Daisy000888/esp32-uart-4g-gateway/doc/preview-3d.png

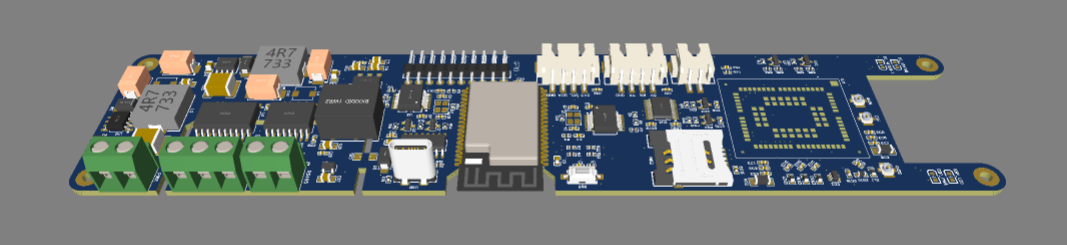
doc/preview-3d.png
