Daisy000888/esp32-uart-4g-gateway/hardware/fabrication/BOM_PCB_ESP32 Quad UARTs with 4G and Display_2022-10-01.csv

ID | Name | Designator | Footprint | Quantity | Manufacturer Part | Manufacturer | Supplier | Supplier Part | Price
1 | PZ254V-12-6P | UART0SEL | HDR-TH_6P-P2.54-V-M-R2-C3-S2.54 | 1 | PZ254V-12-6P | XFCN | LCSC | C492420 | 0.034
2 | 1nF | C35 | C1206 | 1 | 1206B102K202NT | FH | LCSC | C9196 | 0.011
3 | 1.2MΩ | R26 | R1206 | 1 | 1206W4F1204T5E | UniOhm | LCSC | C22107 | 0.004
4 | 1MΩ | R21 | R0402 | 1 | 0402WGF1004TCE | UniOhm | LCSC | C26083
5 | 19-217/GHC-YR1S2/3T | EG_NETLIGHT,EG_STATUS,ESP_LED,ESP_PWR | LED0603-R-RD | 4 | 19-217/GHC-YR1S2/3T | EVERLIGHT | LCSC | C72043 | 0.028
6 | 100nF | C34,C31,C32,C30,EC14,C20,C21,C22,C23,C26,C28,C3,C6,C11,C12,EC3,EC7,EC13,C1 | C0402 | 19 | CL05B104KB54PNC | Samsung Electro-Mechanics | LCSC | C307331 | 0.007
7 | 10kΩ | R20,R4,R5,R6,R14,R1 | R0402 | 6 | 0402WGF1002TCE | UniOhm | LCSC | C25744 | 0.001
8 | 1kΩ | R22,R23 | R0402 | 2 | 0402WGF1001TCE | UniOhm | LCSC | C11702
9 | A2501WR-S-2P | ESP_BTN | CONN-SMD_A2501WR-S-2P | 1 | A2501WR-S-2P | Changjiang Connectors | LCSC | C273220 | 0.173
10 | KH-IPEX-K501-29 | DIV,GNSS,MAIN | ANT-SMD_KH-IPEX-K501-29 | 3 | KH-IPEX-K501-29 | Shenzhen Kinghelm Elec | LCSC | C411563 | 0.071
11 | XC6206P332MR | U9 | SOT-23-3_L2.9-W1.6-P1.90-LS2.8-BR | 1 | XC6206P332MR | TOREX | LCSC | C5446 | 0.103
12 | B0505D-1WR2 | U8 | PWRM-TH_BXXXXD-1WR2 | 1 | B0505D-1WR2 | MORNSUN | LCSC | C40604 | 2.595
13 | 22uF | C14,C15,C29,C24,C25,C27 | C0805 | 6 | CL21A226MPQNNNE | SAMSUNG | LCSC | C29277 | 0.009
14 | 22uF/50V | C37,C43 | C2220 | 2 | FS55X226K500EHG | PSA(Prosperity Dielectrics) | LCSC | C784103 | 0.651
15 | 1uF/50V | C39,C44 | C0805 | 2 | CL21B105KBFNNNE | SAMSUNG | LCSC | C28323 | 0.004
16 | 220uF | C40,C41,C45,C46 | CAP-SMD_L7.3-W4.3-R-RD | 4 | TAJD227K010RNJ | AVX | LCSC | C8024 | 0.492
17 | 1uF | C42,C47 | C0805 | 2 | CL21B105KBFNNNE | SAMSUNG | LCSC | C28323 | 0.004
18 | TPD1E1B04DPYR-TP | D1,D2 | DFN1006-2L-BI | 2 | TPD1E1B04DPYR-TP | TECH PUBLIC | LCSC | C521892 | 0.045
19 | SS34 | D3,D9 | DO-214AC_L4.3-W2.7-LS5.3-RD | 2 | SS34 | MDD | LCSC | C8678 | 0.031
20 | SS54_C22452 | D4,D5 | SMA_L4.4-W2.8-LS5.4-R-RD | 2 | SS54 | MDD | LCSC | C22452 | 0.052
21 | 68uH/3A | L3,L5 | IND-SMD_L11.5-W10.0_104CDMCCDS | 2 | YSPI1050-680M | YJYCOIN | LCSC | C497902 | 0.439
22 | 3.3uH/3A | L4,L6 | IND-SMD_L4.6-W4.2_SMMS0420 | 2 | SMMS0420-3R3M | SXN | LCSC | C133192 | 0.198
23 | 3.3kΩ | R39 | R0402 | 1 | 0402WGF3301TCE | UniOhm | LCSC | C25890
24 | 620Ω | R40 | R0402 | 1 | 0402WGF6200TCE | UniOhm | LCSC | C4961
25 | XL1509-5.0_C2902368 | U5 | SOIC-8_L4.9-W3.9-P1.27-LS6.0-TR | 1 | XL1509-5.0 | UMW(友台半导体) | LCSC | C2902368 | 0.249
26 | AMS1117-3.3 | U10 | SOT-223-3_L6.5-W3.4-P2.30-LS7.0-BR | 1 | AMS1117-3.3 | AMS | LCSC | C6186 | 0.152
27 | XL1509-3.3E1 | U18 | SOP-8_L4.9-W3.9-P1.27-LS6.0-BL | 1 | XL1509-3.3E1 | XLSEMI | LCSC | C74193 | 0.196
28 | KF126-5.0-2P | PWR,RS485 | CONN-TH_P5.00_KF126-5.0-2P | 2 | KF126-5.0-2P | Cixi Kefa Elec | LCSC | C474900 | 0.079
29 | 100pF | EC15 | C0402 | 1 | 0402CG101J500NT | FH | LCSC | C1546 | 0.001
30 | 47nH | EL1 | L0603 | 1 | SDCL1608C47NJTDF | Sunlord | LCSC | C29683 | 0.009
31 | 10Ω | ER10 | R0603 | 1 | 0603WAF100JT5E | UniOhm | LCSC | C22859 | 0.001
32 | 100nF 50V | C16,C17,C18,C19 | C0402 | 4 | CL05B104KB54PNC | Samsung Electro-Mechanics | LCSC | C307331 | 0.007
33 | 120Ω | R17 | R1206 | 1 | 1206W4F1200T5E | UniOhm | LCSC | C17909 | 0.003
34 | 4.7kΩ | R18,R19,ER1,ER4,ER7,ER11,R2,R3 | R0402 | 8 | 0402WGF4701TCE | UniOhm | LCSC | C25900 | 0.001
35 | ADM3251EARWZ-REEL | U6 | SOIC-20_L13.0-W7.6-P1.27-LS10.3-BL | 1 | ADM3251EARWZ-REEL | ADI | LCSC | C13749 | 4.728
36 | ADM2483BRWZ-REEL | U7 | SOIC-16_L10.3-W7.5-P1.27-LS10.3-BL | 1 | ADM2483BRWZ-REEL | ADI | LCSC | C9637 | 3.633
37 | KF126-5.0-3P | RS232 | CONN-TH_3P-P5.00_KF126-5.0-3P | 1 | KF126-5.0-3P | Cixi Kefa Elec | LCSC | C474901 | 0.125
38 | A2501WR-S-4P | I2C,NEXTION | CONN-SMD_A2501WR-S-4P | 2 | A2501WR-S-4P | Changjiang Connectors | LCSC | C273222 | 0.232
39 | K2-1107ST-A4SW-06 | RST | KEY-SMD_L6.2-W3.6-LS8.0 | 1 | K2-1107ST-A4SW-06 | Rectangular Connectors - Contacts | LCSC | C118141 | 0.071
40 | 22pF | C4,C5 | C0402 | 2 | 0402CG220J500NT | FH | LCSC | C1555 | 0.001
41 | 5.1kΩ | R7,R12,R13,R15,R16 | R0402 | 5 | 0402WGF5101TCE | UniOhm | LCSC | C25905
42 | WK2132-ISSG | U2 | SSOP-16_L7.2-W5.3-P0.65-LS7.8-BL | 1 | WK2132-ISSG | WEIKAI | LCSC | C401039 | 2.033
43 | SX3B14.7456F2010F30 | X1 | CRYSTAL-SMD_4P-L3.2-W2.5-BL-2 | 1 | SX3B14.7456F2010F30 | SCTF(星通时频) | LCSC | C2901666 | 0.106
44 | 4.7uF | C13 | C0603 | 1 | CL10A475KO8NNNC | SAMSUNG | LCSC | C19666 | 0.008
45 | S9013 J3 | Q1,Q2 | SOT-23-3_L2.9-W1.3-P1.90-LS2.4-BR | 2 | S9013 J3 | CJ | LCSC | C6749 | 0.015
46 | CH340C | U4 | SOP-16_L10.0-W3.9-P1.27-LS6.0-BL | 1 | CH340C | WCH | LCSC | C84681 | 0.469
47 | TYPE-C-14PIN_c168704 | USB | USB-C-TH_TYPE-C-USB-14P | 1 | - | LCSC | LCSC | C168704 | 0.41
48 | 10pF | EC1,EC5 | C0402 | 2 | CL05C100JB5NNNC | SAMSUNG | LCSC | C32949 | 0.004
49 | 33pF | EC2,EC6,EC10,EC11,EC12 | C0402 | 5 | 0402CG330J500NT | FH | LCSC | C1562 | 0.001
50 | 100uF | EC4,EC8 | C1206 | 2 | CL31A107MQHNNNE | SAMSUNG | LCSC | C15008 | 0.069
51 | 10nF | EC9,EC16 | C0402 | 2 | CL05B103KB5NNNC | SAMSUNG | LCSC | C15195 | 0.001
52 | 100nF | EC79,EC80 | C0402_NEW | 2 | CL05B104KO5NNNC | SAMSUNG | LCSC | C1525 | 0.001
53 | SMF05C_C558425 | ED2 | SOT-363_L2.0-W1.3-P0.65-LS2.1-TL | 1 | SMF05C | TECH PUBLIC | LCSC | C558425 | 0.055
54 | MMBT3904-C20526 | EQ1,EQ2,EQ3,EQ4 | SOT-23-3_L2.9-W1.3-P1.90-LS2.4-BR | 4 | MMBT3904 | CJ | LCSC | C20526 | 0.011
55 | 47kΩ | ER2,ER3,ER8,ER12 | R0402 | 4 | 0402WGF4702TCE | UniOhm | LCSC | C25792
56 | 2.2kΩ | ER5,ER6 | R0402 | 2 | 0402WGF2201TCE | UniOhm | LCSC | C25879
57 | 22Ω | ER19,ER20,ER21 | R0603 | 3 | 0603WAF220JT5E | UniOhm | LCSC | C23345 | 0.001
58 | SMC-216 | ESIM | SIM-SMD_SMC-216 | 1 | SMC-216 | XUNPU | LCSC | C266883 | 0.212
59 | EG95EXGA-128-SGNS | EU1 | XCVR_EG95EXGA-128-SGNS | 1 | EG95EXGA-128-SGNS | Quectel | Digi-Key | 2958-EG95EXGA-128-SGNSTR-ND
60 | TXB0108PWR | EU3 | TSSOP-20_L6.5-W4.4-P0.65-LS6.4-BL | 1 | TXB0108PWR | TI | LCSC | C53406 | 0.574
61 | 100nF | C2 | C0603 | 1 | CC0603KRX7R9BB104 | YAGEO | LCSC | C14663 | 0.002
62 | ESP32-WROVER-IB(16MB) | U1 | WIFIM-SMD_39P-L31.4-W18.0-P1.27 | 1 | ESP32-WROVER-IB(16MB) | Espressif Systems | LCSC | C529592 | 6.108
