Daisy000888/esp32-uart-4g-gateway/doc/Schematic_ESP32 Quad UARTs with 4G and Display_2022-10-01.pdf

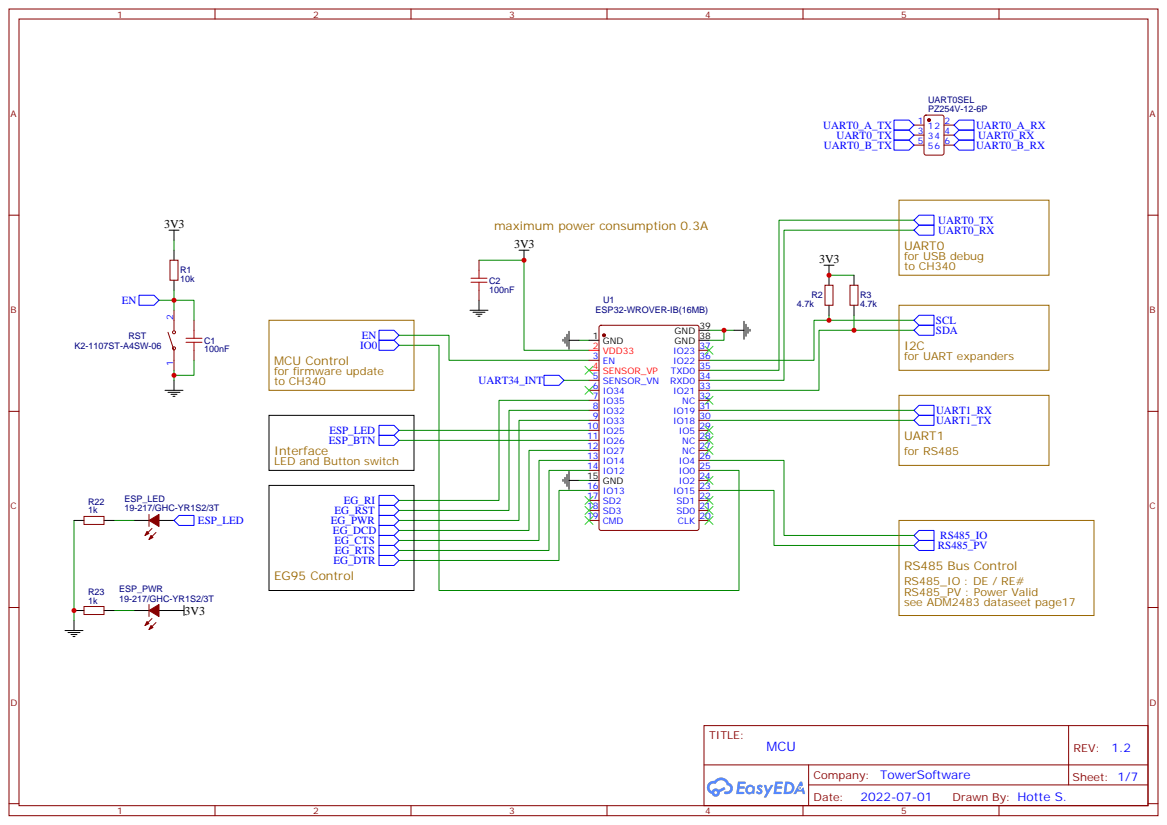
[picture p4: page 1]

Interface
LED and Button switch

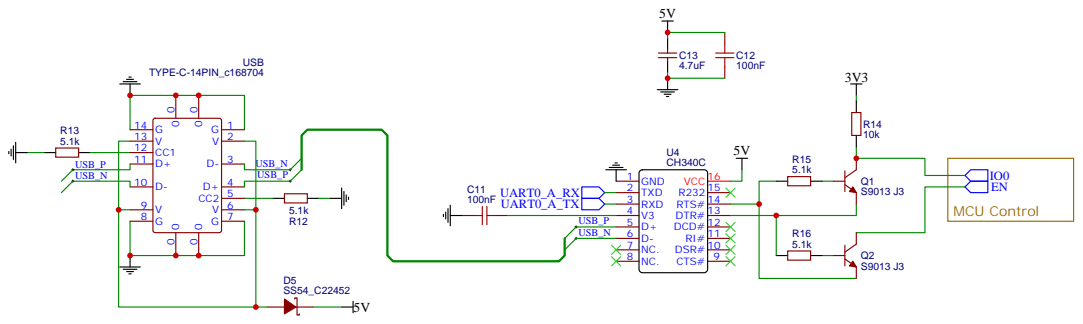
[picture p5: page 2]

# TX2 10 RX2 11 GND 12 MD0 13 MD1 14 TX1 15 RX1 16

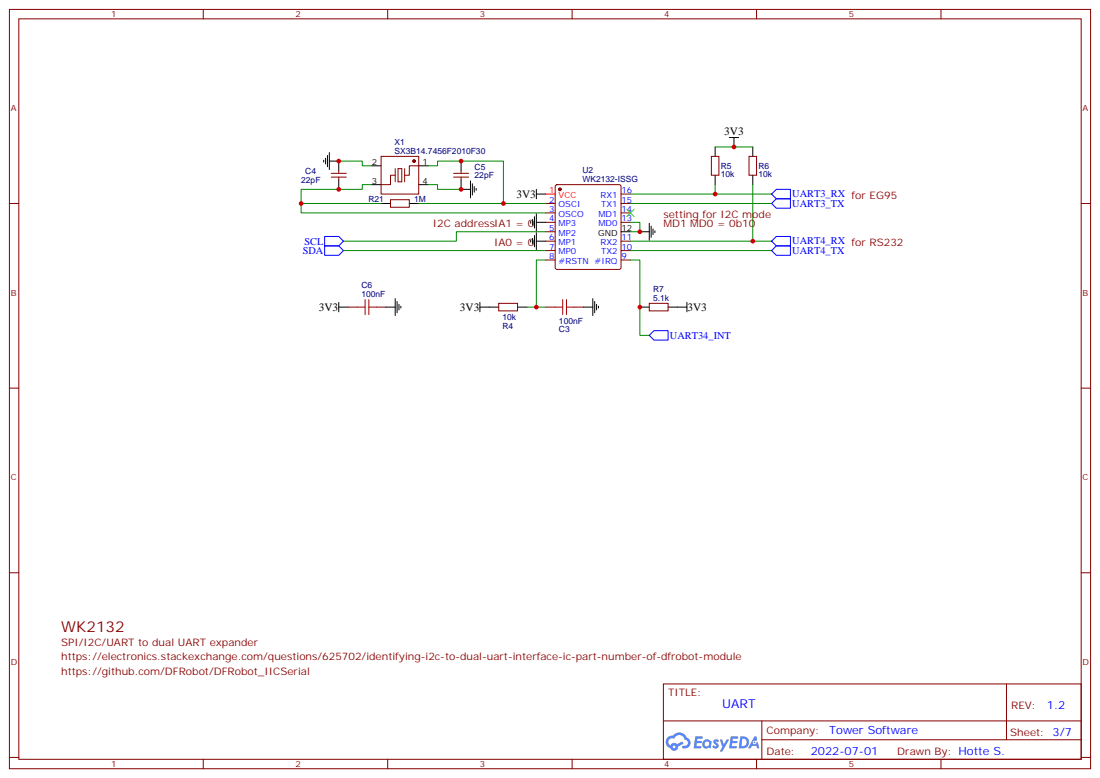
[picture p6: page 3]

SPI/I2C/UART to dual UART expander
https://electronics.stackexchange.com/questions/625702/identifying-i2c-to-dual-uart-interface-ic-part-number-of-dfrobot-module
https://github.com/DFRobot/DFRobot_IICSerial

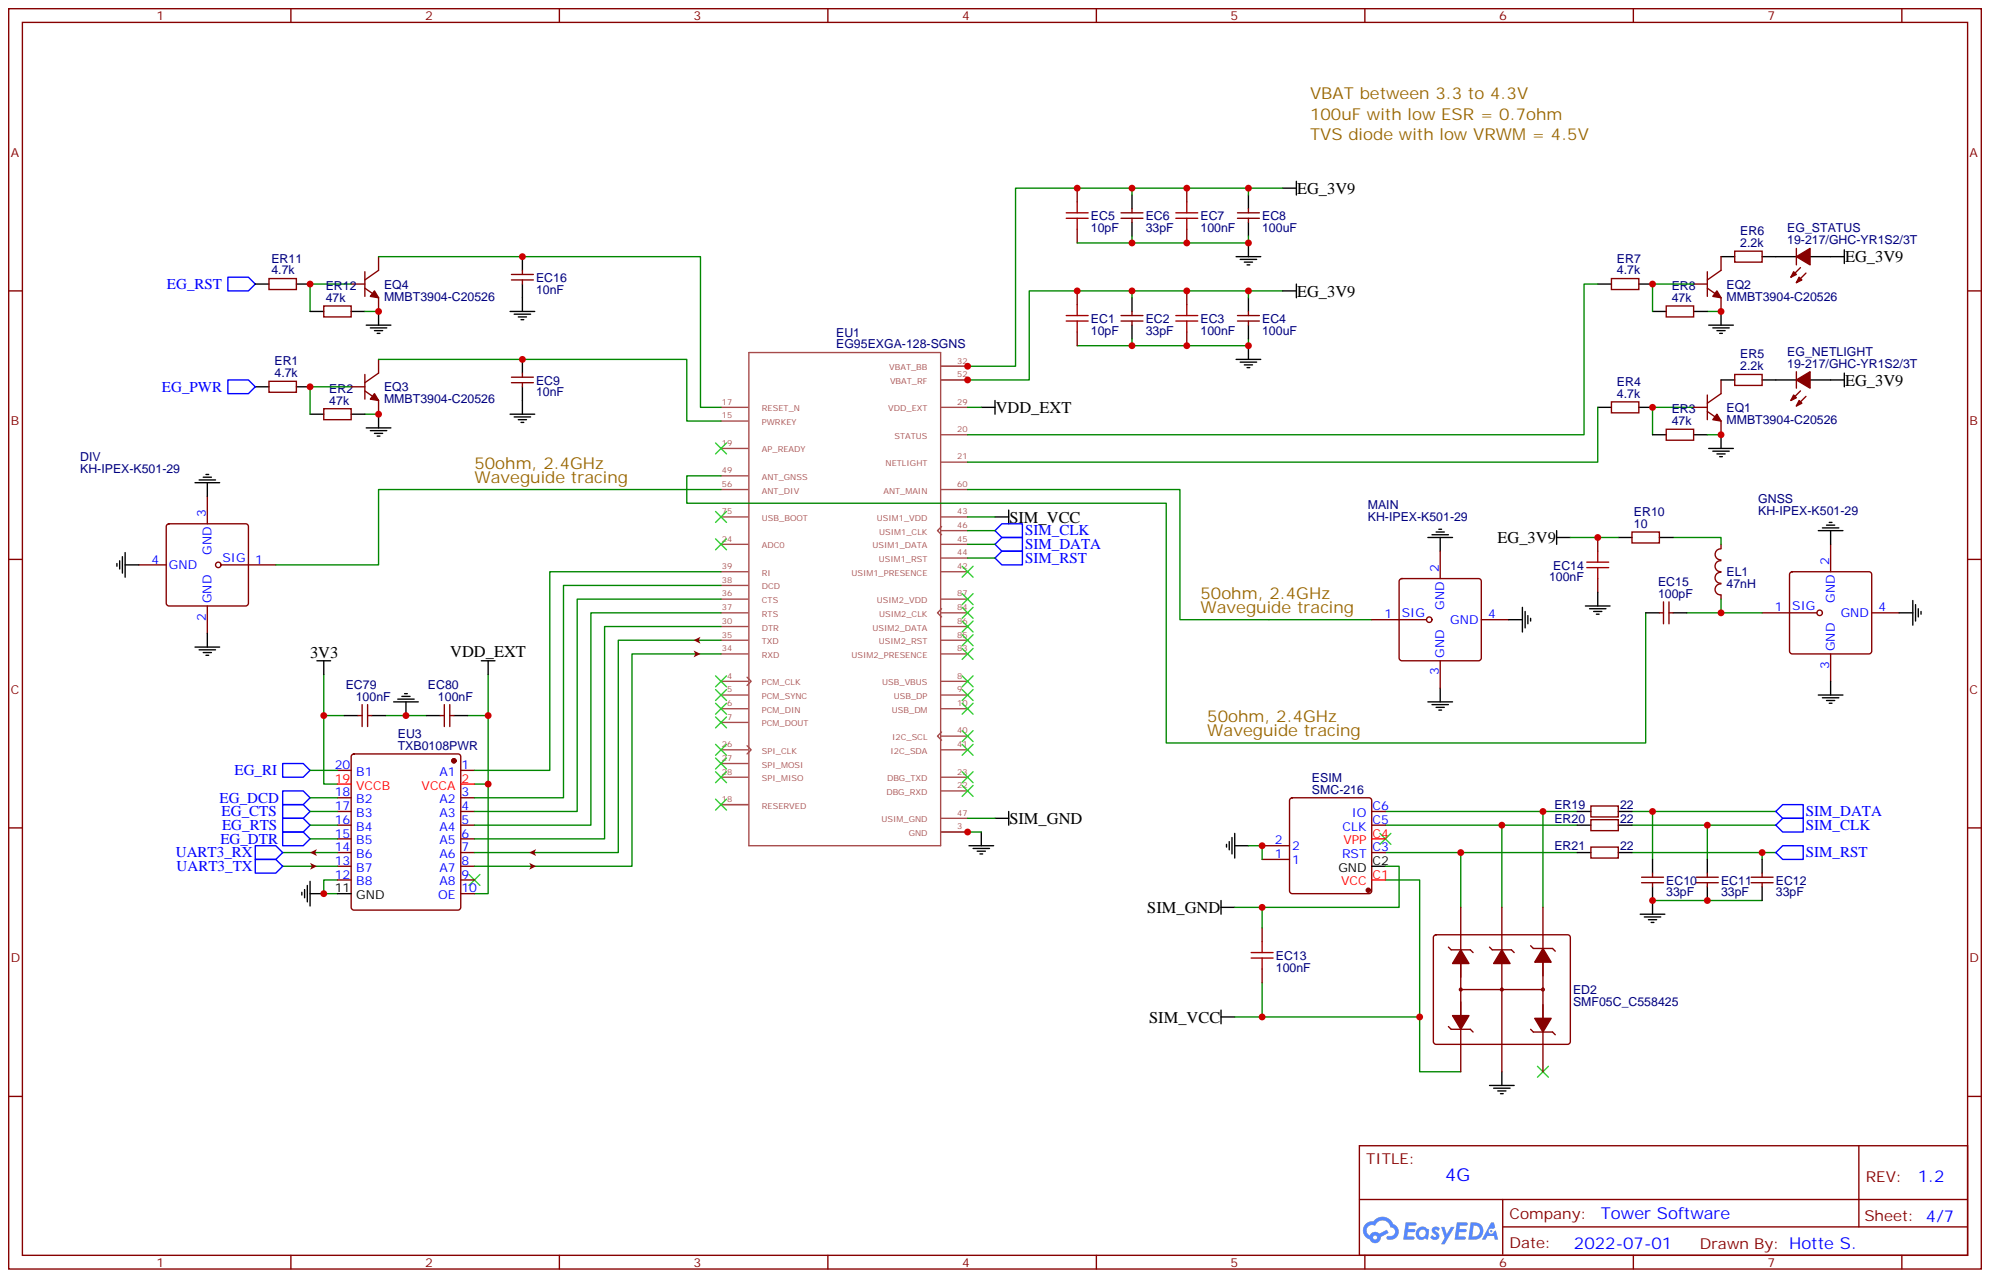
[picture p7: page 4]

VBAT between 3.3 to 4.3V
100uF with low ESR = 0.7ohm
TVS diode with low VRWM = 4.5V

## Isolated Ports

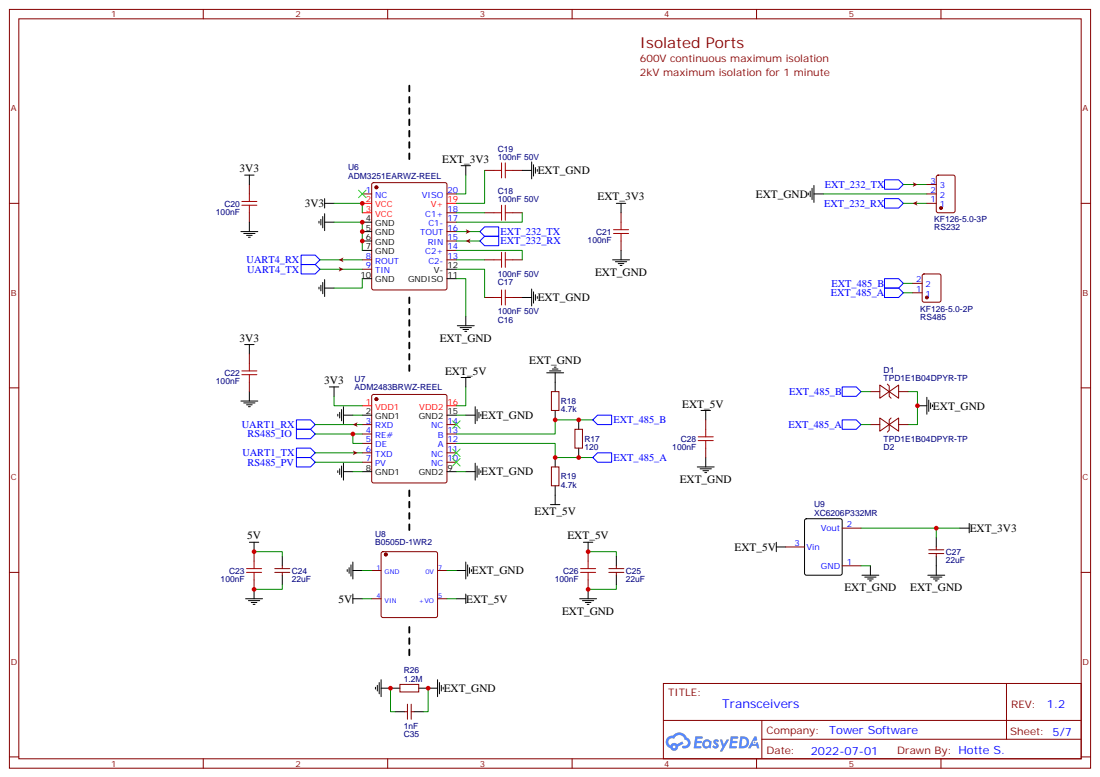
[picture p8: page 5]

600V continuous maximum isolation
2kV maximum isolation for 1 minute

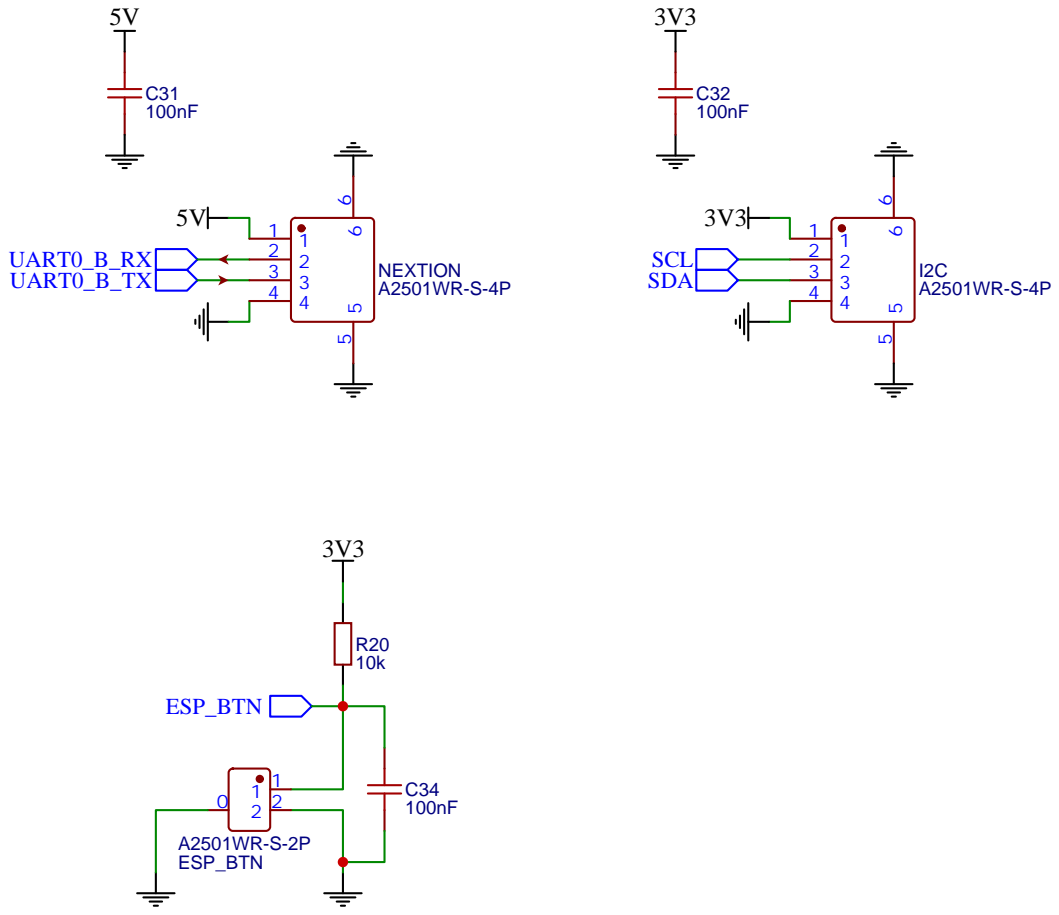
[picture p9: page 6]

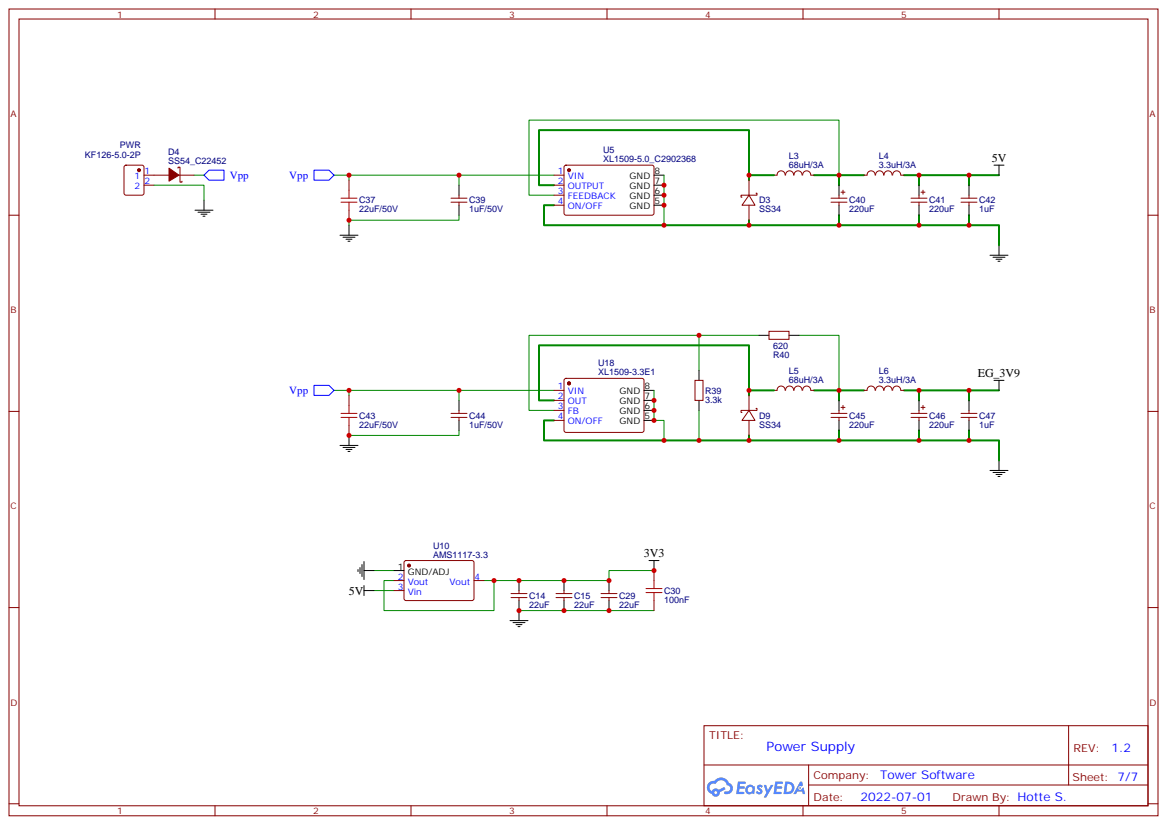
[picture p10: page 7]
