Daisy000888/esp32-uart-4g-gateway/(list of files, drawings)

Other design files:
hardware/easyeda/PCB_PCB_ESP32 Quad UARTs with 4G and Display_2022-07-24.json
hardware/easyeda/PCB_PCB_ESP32 Quad UARTs with 4G and Display_2022-10-01.json
hardware/easyeda/SCH_ESP32 Quad UARTs with 4G and Display_2022-07-24.json
hardware/easyeda/SCH_ESP32 Quad UARTs with 4G and Display_2022-10-01.json
