Daisy000888/esp32-uart-4g-gateway/(commit log)

2022-07-24 initial commit.
    [BOM_PCB_ESP32 Quad UARTs with 4G and Display_2022-07-24.csv, PCB_PCB_ESP32 Quad UARTs with 4G and Display_2022-07-24.json, PickAndPlace_PCB_ESP32 Quad UARTs with 4G and Display_2022-07-24.csv, SCH_ESP32 Quad UARTs with 4G and Display_2022-07-24.json]
2022-09-30 rev: 1.2
    [BOM_PCB_ESP32 Quad UARTs with 4G and Display_2022-07-24.csv, BOM_PCB_ESP32 Quad UARTs with 4G and Display_2022-10-01.csv, PCB_PCB_ESP32 Quad UARTs with 4G and Display_2022-10-01.json, PickAndPlace_PCB_ESP32 Quad UARTs with 4G and Display_2022-07-24.csv, PickAndPlace_PCB_ESP32 Quad UARTs with 4G and Display_2022-10-01.csv, SCH_ESP32 Quad UARTs with 4G and Display_2022-10-01.json]
